CRM-UAM/CRMaze32/GyroGreenBreakout.png

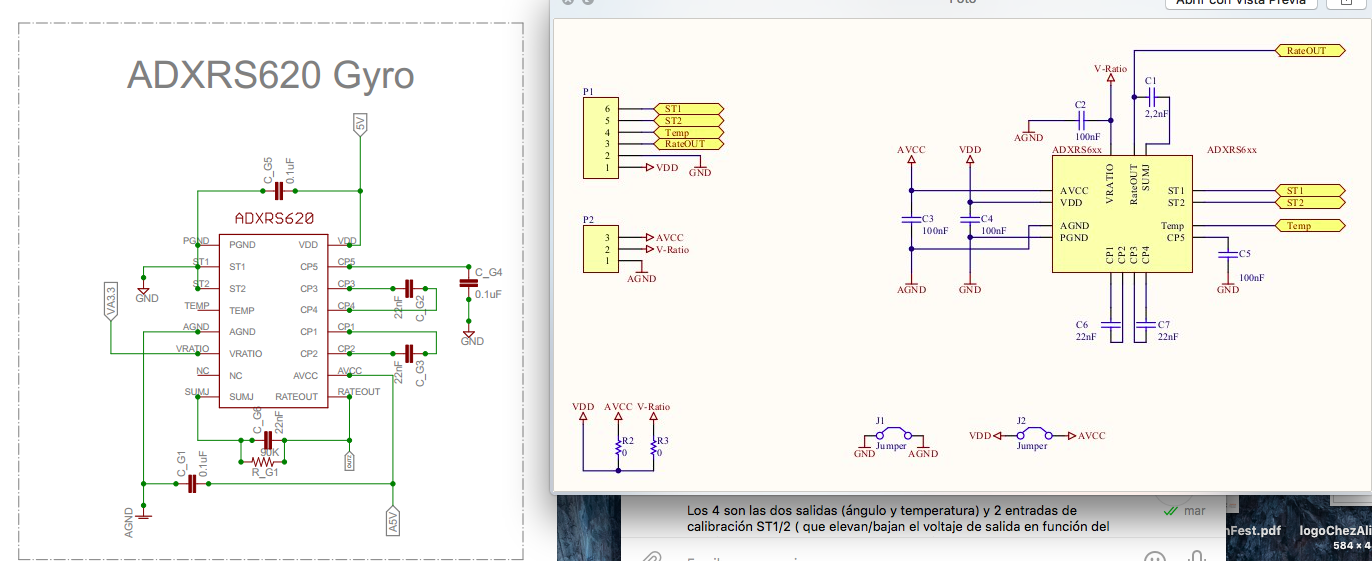
GyroGreenBreakout.png
