CRM-UAM/CRMaze32/IR-Led-Emmiter-System_Green.png

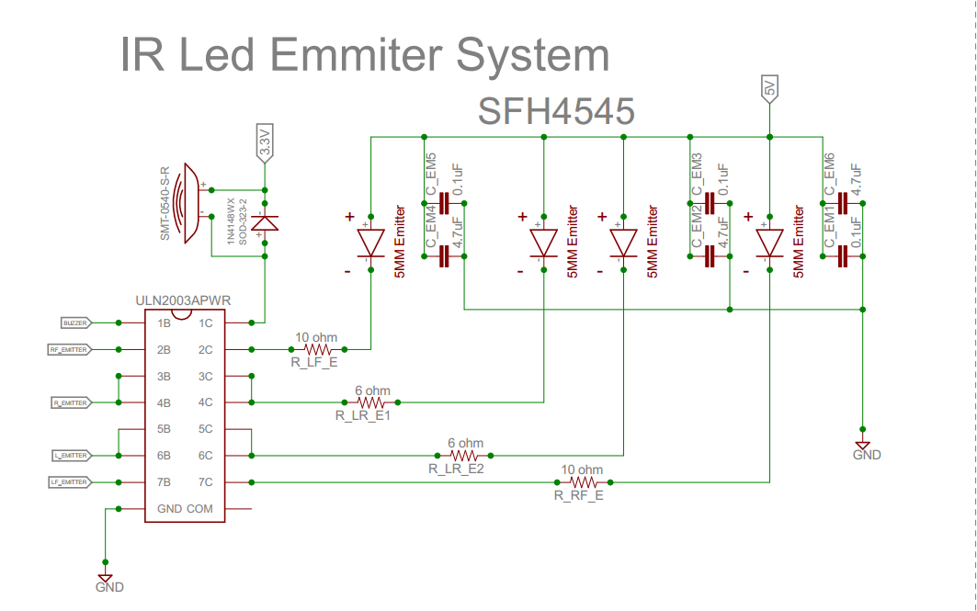
IR-Led-Emmiter-System_Green.png
