CRM-UAM/CRMaze32/potenciaGreen.png

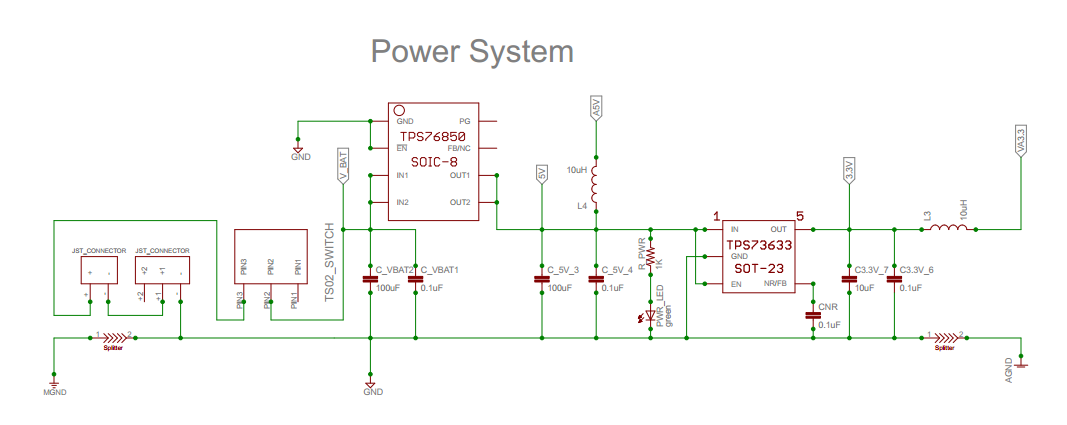
potenciaGreen.png
