CRM-UAM/CRMaze32/Componentes.xlsx

 | Lista Componentes Micromouse ESP32 |  |  |  | 58.39 € |  | Selección Componentes: | Si
 | Sistema | Nº | Componente | Observaciones | Precio | Tienda |  |  | 43.77 €
Si | GYRO ANALÓGICO | 1 | ADXRS620 Breakout |  | 9.95 € | http://www.watterott.com/index.php?page=product&info=1703 | Etiquetas de fila | Unidades Totales | Precio/unidad
Si | MOTOR DRIVER POLOLU | 1 | DVR8825_dual_pololu |  | 5.47 € | http://www.watterott.com/en/DRV8835-Dual-Motor-Driver-Carrier | ADXRS620 Breakout | 1 | 9.95 €
Si | IR RECEIVER | 6 | Resistencia SMD |  | 0.10 € | http://www.mouser.es/Passive-Components/Resistors/SMD-Resistors-Chip-Resistors/_/N-7h7yu/?Ns=Pricing|0 | Boton SMD | 5 | 0.50 €
Si | IR RECEIVER | 6 | IR receptor |  | 0.66 € | http://www.mouser.es/ProductDetail/Vishay-Semiconductors/TEFT4300/?qs=HsFHTXumnCRbcrt8oPFPMA%3D%3D | Buzzer SMD | 1 | 3.30 €
No | IR EMMITER A) | 8 | Resistencia SMD |  |  |  | Condensador SMD | 17
No | IR EMMITER A) | 4 | Transistor |  |  |  | Conectores | 2
No | IR EMMITER A) | 6 | IR emisor 5V |  | 0.55 € | http://www.mouser.es/_/?Keyword=SFH4545&FS=True | Diodo SMD | 1 | 0.17 €
Si | IR EMMITER B) | 4 | Resistencia SMD |  | 0.10 € | http://www.mouser.es/Passive-Components/Resistors/SMD-Resistors-Chip-Resistors/_/N-7h7yu/?Ns=Pricing|0 | DVR8825_dual_pololu | 1 | 5.47 €
Si | IR EMMITER B) | 1 | ULN2003A |  | 0.37 € | http://www.mouser.es/All-Manufacturers/_/N-0?Keyword=ULN2003APWR&FS=True | ESP-WROOM-32 | 1 | 4.75 €
Si | IR EMMITER B) | 6 | IR emisor 5V |  | 0.55 € | http://www.mouser.es/_/?Keyword=SFH4545&FS=True | Inductor SMD | 2
Si | IR EMMITER B) | 8 | Condensador SMD |  | 0.15 € | http://www.mouser.es/Passive-Components/Capacitors/Aluminum-Electrolytic-Capacitors/_/N-75hqt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|0 | IR emisor 5V | 6 | 0.55 €
No | BUZZER A) | 1 | Buzzer SMD |  | 3.30 € | http://www.mouser.es/ProductDetail/PUI-Audio/SMT-0540-S-R/ | IR receptor | 6 | 0.66 €
No | BUZZER A) | 1 | Diodo SMD |  | 0.17 € | http://www.mouser.es/ProductDetail/Micro-Commercial-Components-MCC/1N4148WX-TP/ | Led SMD | 11 | 0.50 €
No | BUZZER A) | 1 | Transistor |  | 0.40 € | http://www.mouser.es/ProductDetail/Infineon/IRLML6344TRPBF/ | Pulsador smd | 1
No | BUZZER A) | 1 | Resistencia SMD |  |  |  | Resistencia SMD | 31
Si | BUZZER B) | 1 | Buzzer SMD |  | 3.30 € | http://www.mouser.es/ProductDetail/PUI-Audio/SMT-0540-S-R/ | Splitter | 2
Si | BUZZER B) | 1 | Diodo SMD |  | 0.17 € | http://www.mouser.es/ProductDetail/Micro-Commercial-Components-MCC/1N4148WX-TP/ | Switch | 1
No | POWER SYSTEM A) | 1 | LD1117S50TR |  |  |  | TPS73633 | 1 | 1.88 €
No | POWER SYSTEM A) | 1 | LD1117S33TR |  |  |  | TPS76850 | 1 | 2.62 €
No | POWER SYSTEM A) | 4 | Condensador SMD |  |  |  | ULN2003A | 1 | 0.37 €
Si | POWER SYSTEM B) | 1 | TPS76850 |  | 2.62 € | http://www.mouser.es/Semiconductors/Power-Management-ICs/Voltage-Regulators-Voltage-Controllers/LDO-Voltage-Regulators/_/N-5cgac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
Si | POWER SYSTEM B) | 1 | TPS73633 |  | 1.88 € | http://www.mouser.es/_/?Keyword=TPS73633+SOT-23&FS=True
Si | POWER SYSTEM B) | 7 | Condensador SMD |  | 0.15 € | http://www.mouser.es/Passive-Components/Capacitors/Aluminum-Electrolytic-Capacitors/_/N-75hqt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|0
Si | POWER SYSTEM B) | 2 | Inductor SMD |  | 0.15 € | http://www.mouser.es/Passive-Components/Inductors-Chokes-Coils/Fixed-Inductors/_/N-wpcz?P=1z0z7ym&Ns=Pricing|0
Si | POWER SYSTEM B) | 2 | Splitter |  | 0.25 € | http://www.mouser.es/Passive-Components/Inductors-Chokes-Coils/Fixed-Inductors/_/N-wpcz?P=1z0z7ym&Ns=Pricing|0
Si | BATERY | 2 | Conectores
Si | BATERY | 1 | Switch |  | 0.50 € | http://www.mouser.es/Electromechanical/Switches/Pushbutton-Switches/_/N-5g30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
Si | BATERY | 3 | Resistencia SMD |  | 0.10 € | http://www.mouser.es/Passive-Components/Resistors/SMD-Resistors-Chip-Resistors/_/N-7h7yu/?Ns=Pricing|0
Si | BATERY | 1 | Led SMD |  | 0.50 € | http://www.mouser.es/Optoelectronics/LED-Lighting/LED-Emitters/Standard-LEDs-SMD/_/N-b1bb1
Si | MODE INDICATOR | 10 | Resistencia SMD |  | 0.10 € | http://www.mouser.es/Passive-Components/Resistors/SMD-Resistors-Chip-Resistors/_/N-7h7yu/?Ns=Pricing|0
Si | MODE INDICATOR | 10 | Led SMD |  | 0.50 € | http://www.mouser.es/Optoelectronics/LED-Lighting/LED-Emitters/Standard-LEDs-SMD/_/N-b1bb1
Si | MODE INDICATOR | 5 | Boton SMD |  | 0.50 € | http://www.mouser.es/Electromechanical/Switches/Pushbutton-Switches/_/N-5g30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
Si | MODE INDICATOR | 5 | Resistencia SMD |  | 0.10 € | http://www.mouser.es/Passive-Components/Resistors/SMD-Resistors-Chip-Resistors/_/N-7h7yu/?Ns=Pricing|0
Si | MICROCONTROLER | 1 | ESP-WROOM-32 |  | 4.75 € | http://www.watterott.com/en/ESP-WROOM-32-Module
Si | MICROCONTROLER | 3 | Resistencia SMD |  | 0.10 € | http://www.mouser.es/Passive-Components/Resistors/SMD-Resistors-Chip-Resistors/_/N-7h7yu/?Ns=Pricing|0
Si | MICROCONTROLER | 1 | Pulsador smd |  | 0.50 € | http://www.mouser.es/Electromechanical/Switches/Pushbutton-Switches/_/N-5g30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
Si | MICROCONTROLER | 2 | Condensador SMD |  | 0.15 € | http://www.mouser.es/Passive-Components/Capacitors/Aluminum-Electrolytic-Capacitors/_/N-75hqt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|0
 |  |  |  |  | 37.12 €
 |  |  | 805 | 1,8k
 |  |  |  | 10ohm
 |  |  |  | 1k
