CRM-UAM/CRMaze32/CRMaze32_Schematic.pdf

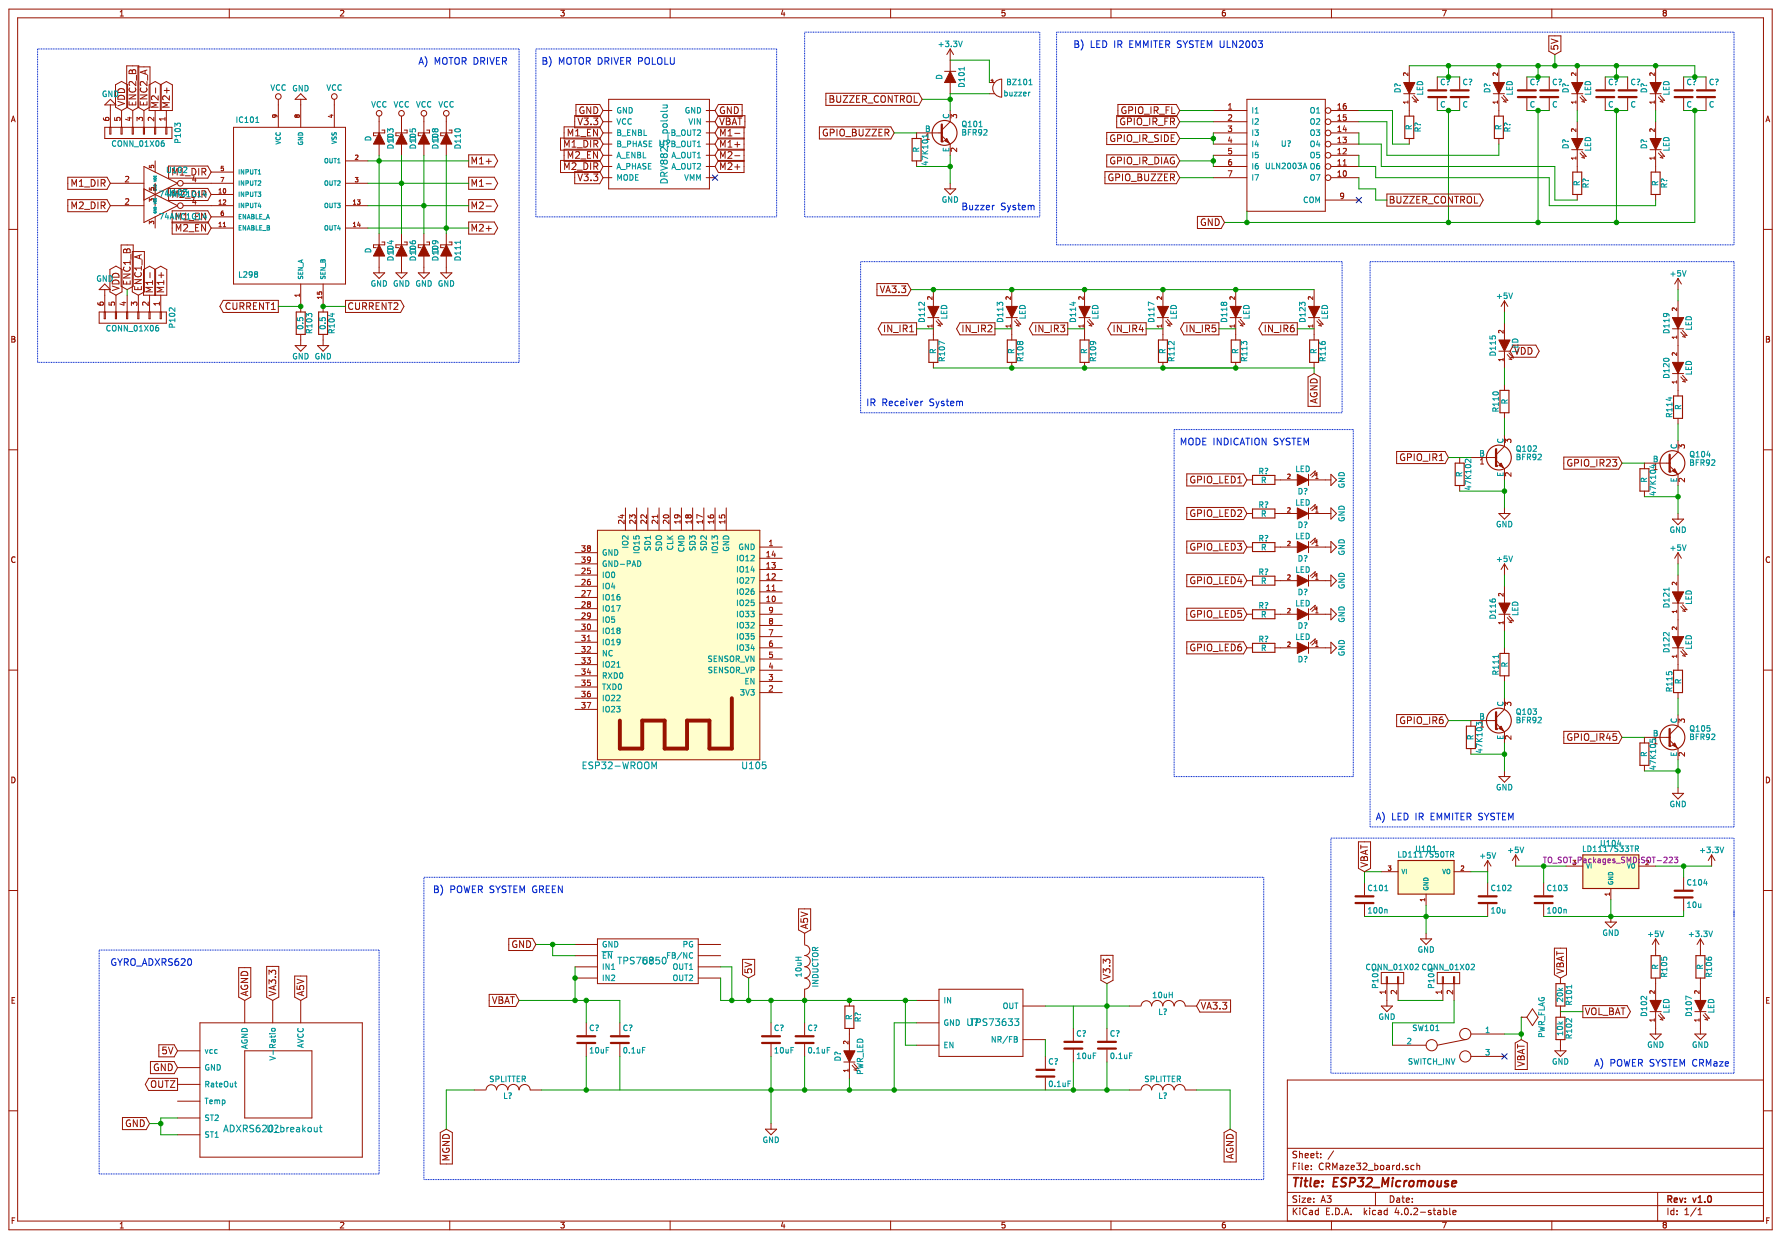
[picture p4: page 1]
