CRM-UAM/CRMaze32/(list of files, drawings)

Other design files:
CRMaze32_board_futura.dsn
