CRM-UAM/CRMaze32/(commit log)

2017-05-28 initial status
    [CRMaze32_board.kicad_pcb, CRMaze32_board.sch, Componentes.xlsx, futura_perimetro.kicad_pcb]
2017-06-04 Placa CRMaze_board_futura con forma y componente colocados
    [CRMaze32_board.sch, CRMaze32_board_futura.dsn, CRMaze32_board_futura.kicad_pcb, Componentes.xlsx, perimetro.kicad_pcb]
2017-06-06 retoques y moificaciones
    [CRMaze32_board.sch, CRMaze32_board_futura.kicad_pcb]
2017-10-05 esquematico finalizado. Componentes colocados. Comienzo del enrutado.
    [CRMaze32_board.sch, CRMaze32_board_futura.kicad_pcb, Componentes.xlsx]
2017-10-06 avances enrutado
    [CRMaze32_board.sch, CRMaze32_board_futura.kicad_pcb]
2017-10-06 pre cambio etiquetas esquematico
    [CRMaze32_board.sch, CRMaze32_board_futura.kicad_pcb]
2017-10-06 arregladas referencias
    [CRMaze32_board.sch, CRMaze32_board_futura.kicad_pcb]
2017-10-07 enrutado OK
    [CRMaze32_board.sch, CRMaze32_board_futura.kicad_pcb]
2017-10-07 enrutado finalizado y serigrafia OK
    [CRMaze32_board_futura.kicad_pcb]
2017-10-08 incluida huella del siwtch a la carpeta local de libs
2017-10-08 cambios minimos serigrafia
    [CRMaze32_board_futura.kicad_pcb]
2017-11-08 calibrado PID para motores 30:1
    [Libro1.xlsx, Trapezoidal-Curve-Turn-Profile-Generator.xlsx]
2017-11-08 ajustado PID moveOneCell()
2017-11-09 Laberinto de test completado con ajustes de PID
